madrigal-a/magsafe-console/hardware/compras.xlsx

Sheet: Resumen
MagSafe Console: lista de compra
Consolas a armar | 4 | Cambia este número y se recalcula la columna «Necesito».
Dónde | Total USD | Nota
Profe (a precio de LCSC) | $5.08 | Referencia para negociar
Profe (a precio de Mouser, pieza suelta) | $22.12 | Parcial: faltan piezas sin precio en Mouser
LCSC (lo que compro yo) | $30.78 | Sin envío ni impuestos
Total estimado (LCSC + profe a precio LCSC) | $35.86
No incluye: batería, pantalla, bocina, conector de la pantalla, placa y esténcil.

Sheet: Comprar al profe
Pieza | Descripción | Número de parte | LCSC | Por consola | Necesito | Pedir (con repuesto) | Precio LCSC (USD) | Subtotal LCSC | Precio Mouser 1 pza (USD) | Subtotal Mouser
Regulador 3.3 V | U2, alimenta todo a 3.3 V | AP2112K-3.3TRG1 | C51118 | 1 | 4 | 4 | 0.173 | $0.69 | 0.26 | $1.04 | x
Conector USB-C | J1, carga y datos | USB4085-GF-A | C165948 | 1 | 4 | 4 | 0.188 | $0.75 | 0.97 | $3.90 | x
MOSFET N | Q2, enciende la luz de la pantalla (reemplaza al AO3400A) | 2N7002 (SOT-23) | C8545 | 1 | 4 | 6 | 0.018 | $0.11 | 0.24 | $1.44 | x
Diodo Schottky | D3, reparto de carga (reemplaza al B5819W) | 1N5819HW-7-F | C82544 | 1 | 4 | 6 | 0.057 | $0.34 | 0.31 | $1.86 | x
Protección USB | Nueva, protege D+ y D- de estática | USBLC6-2P6 | C15999 | 1 | 4 | 6 | 0.249 | $1.49 | 0.69 | $4.14 | x
LED verde 0603 | D2, carga completa | KT-0805G o igual | C2297 | 1 | 4 | 8 | 0.017 | $0.14 |  | $0.14 | x
LED Azul 0603 | D1, cargando | el que tenga en 0603 |  | 1 | 4 | 8 | 0.020 | $0.16 | 0.25 | $2.00 | x
Resistencia 1 kΩ 0603 | R4, R5 |  | C21190 | 2 | 8 | 12 | 0.001 | $0.01 | 0.10 | $1.20 | x
Resistencia 3 kΩ 0603 | R3, corriente de carga |  | C4211 | 1 | 4 | 10 | 0.001 | $0.01 | 0.10 | $1.00 | x
Resistencia 5.1 kΩ 0603 | R1, R2 |  | C23186 | 2 | 8 | 12 | 0.001 | $0.01 | 0.10 | $1.20 | x
Resistencia 1 MΩ 0603 | R10, R11, R12 |  | C22935 | 3 | 12 | 16 | 0.001 | $0.02 | 0.10 | $1.60 | x
Capacitor 100 nF 0603 | C7, C8, C10, C11 |  | C14663 | 4 | 16 | 20 | 0.003 | $0.06 | 0.13 | $2.60 | x
Capacitor 1 µF 0603 | C3, C5 |  | C15849 | 2 | 8 | 12 | 0.006 | $0.07 |  |  | x
Capacitor 15 µF 0805, 10 V o más | C1, C2, C4, C6, C9, C12 |  | C19702 | 6 | 24 | 30 | 0.029 | $0.87 |  |  | x
Interruptor | SW1 (el profe lo tiene después) | MSK12C02 | C431540 | 1 | 4 | 6 | 0.057 | $0.34
TOTAL |  |  |  |  |  |  |  | $5.08 |  | $22.12
 |  |  |  |  |  |  |  |  |  | $25.65
Precios consultados el 13 de noviembre de 2026, sin envío ni impuestos.
Precio LCSC: el de la cantidad mínima de compra. Precio Mouser: por 1 pieza suelta; vacío = no encontré precio o Mouser no vende esa marca.
El subtotal de Mouser solo suma las piezas con precio, así que el total real sería mayor.
Azul = dato que puedes cambiar. «Pedir» incluye repuesto porque las piezas chicas se pierden al soldar.

Sheet: Comprar en LCSC
Pieza | Descripción | Número de parte | LCSC | Por consola | Necesito | Pedir (con repuesto) | Precio LCSC (USD) | Subtotal LCSC
ESP32 | U3, cerebro | ESP32-S3-WROOM-1-N16R8 | C2913202 | 1 | 4 | 4 | 4.950 | $19.80
Amplificador | U4, audio | MAX98357AETE+T | C910544 | 1 | 4 | 5 | 1.310 | $6.55
Cargador | U1, carga la batería | TP4056-42-ESOP8 | C16581 | 1 | 4 | 6 | 0.190 | $1.14
Ranura microSD | J4 | TF-01A | C91145 | 1 | 4 | 5 | 0.190 | $0.95
Botones frontales | SW2 a SW14 | TS-1187A-B-A-B | C318884 | 13 | 52 | 60 | 0.020 | $1.20
Gatillos | SW15, SW16 | TS24CA | C393942 | 2 | 8 | 10 | 0.030 | $0.30
MOSFET P | Q1, reparto de carga | AO3401A | C15127 | 1 | 4 | 6 | 0.090 | $0.54
Resistencia 10 Ω 0603 | R13 (se vende de 100 en 100) |  | C22859 | 1 | 4 | 100 | 0.001 | $0.10
Resistencia 10 kΩ 0603 | R7, R8, R9 (de 100 en 100) |  | C25804 | 3 | 12 | 100 | 0.001 | $0.10
Resistencia 100 kΩ 0603 | R6, R14, R15 (de 100 en 100) |  | C25803 | 3 | 12 | 100 | 0.001 | $0.10
TOTAL |  |  |  |  |  |  |  | $30.78
Precios aproximados de la lista del proyecto (hardware/piezas.md), sin envío ni impuestos; el carrito de LCSC da el precio final.
Algunas piezas tienen mínimo de compra; el carrito ajusta la cantidad.
Si el profe no tiene LED amarillo 0603, agrega el rojo KT-0603R (C2286). Si el interruptor tarda, agrega MSK12C02 (C431540).
