madrigal-a/magsafe-console/hardware/esquematico.pdf

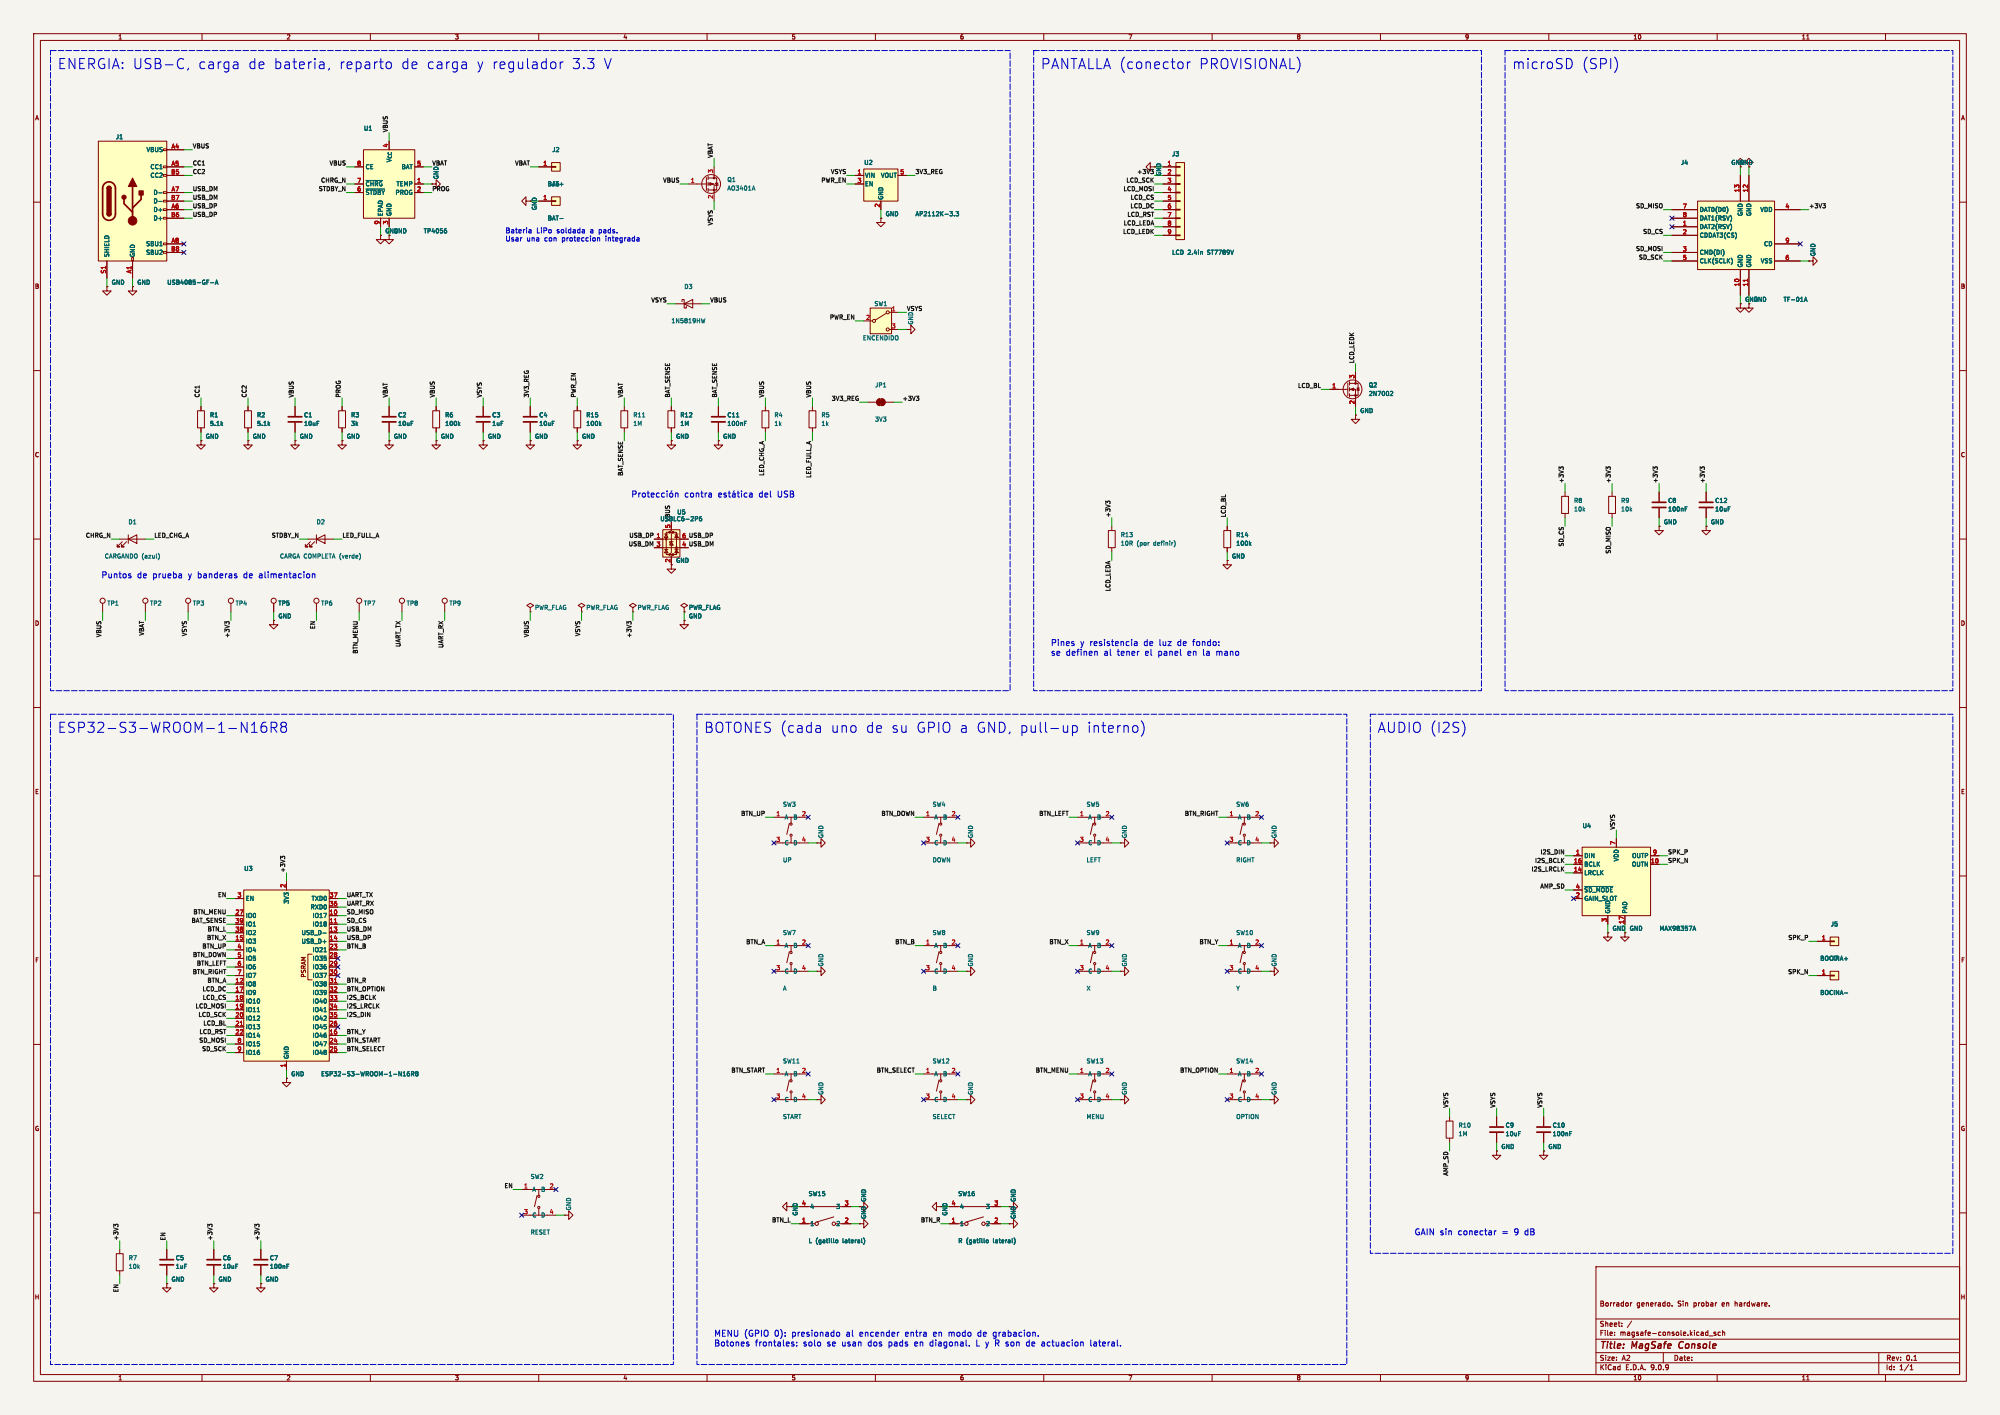
[picture p2: page 1]

3 BAT 5 TEMP 1 PROG 2 GND

þÿProtección contra þÿestática del USB

Puntos de prueba y banderas de alimentacion
