madrigal-a/magsafe-console/hardware/kicad/magsafe-console.kicad_pcb

## KiCad design hardware/kicad/magsafe-console.kicad_pcb (2026-11-13)

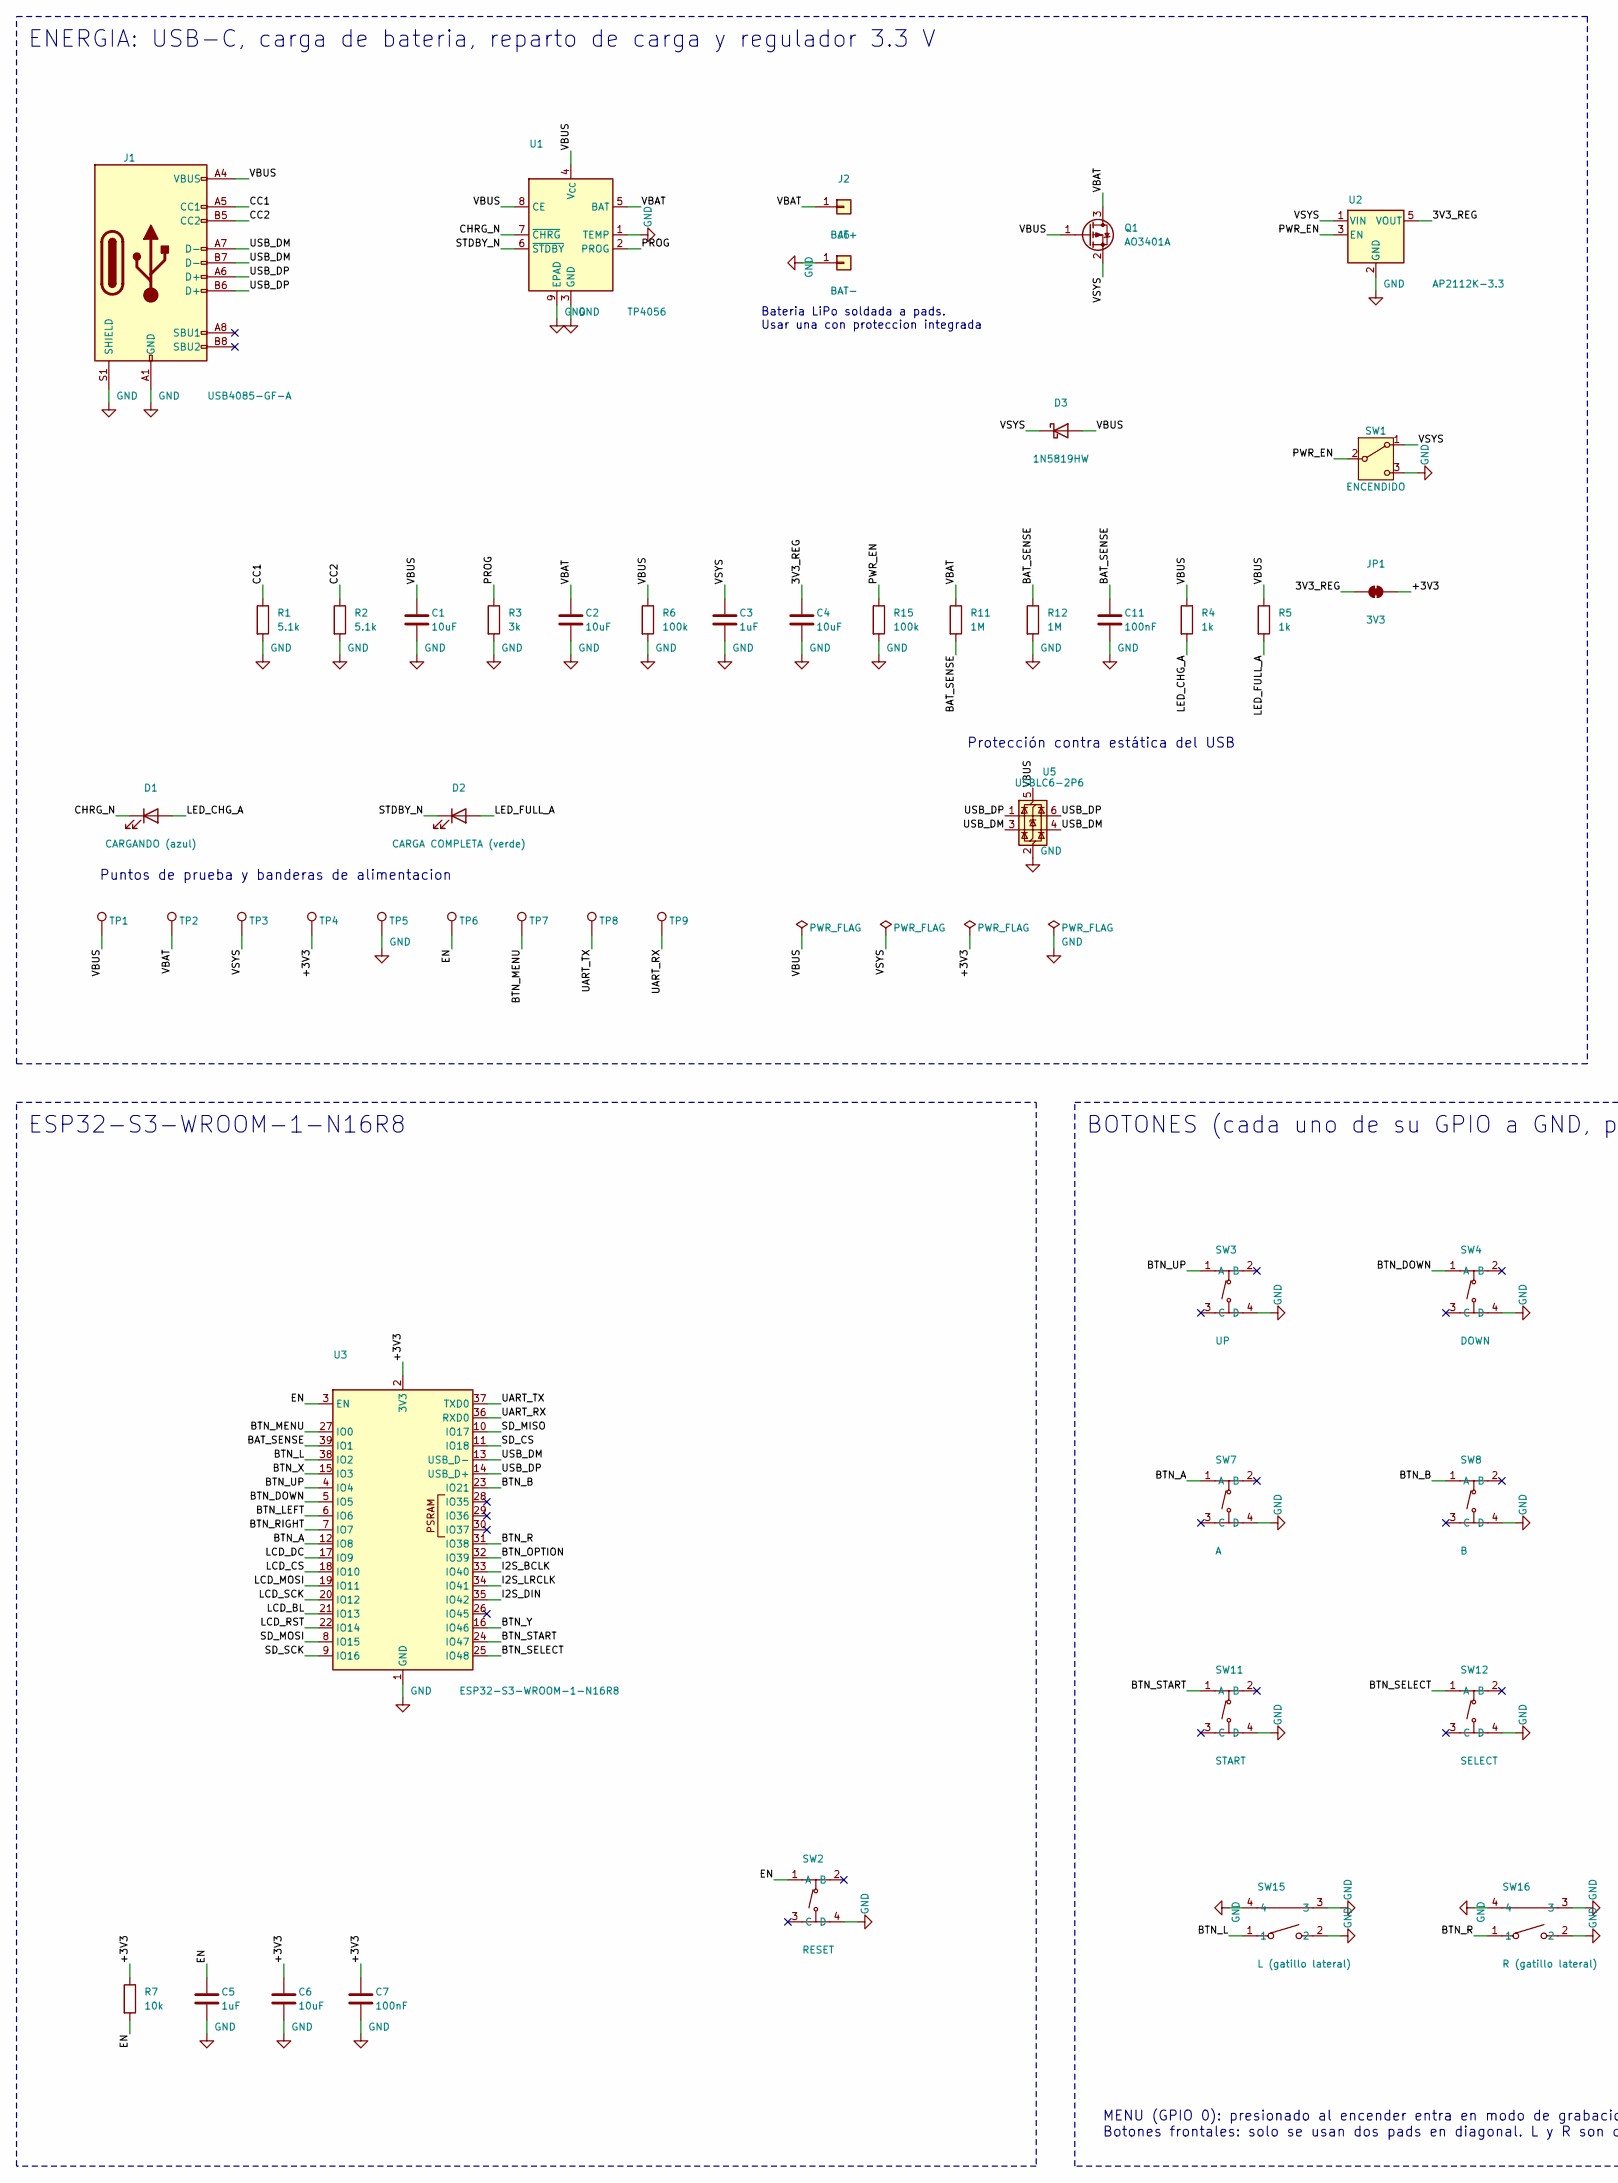
[picture p3: schematic magsafe-console.kicad_sch, MagSafe Console, part in row 1, column 1]

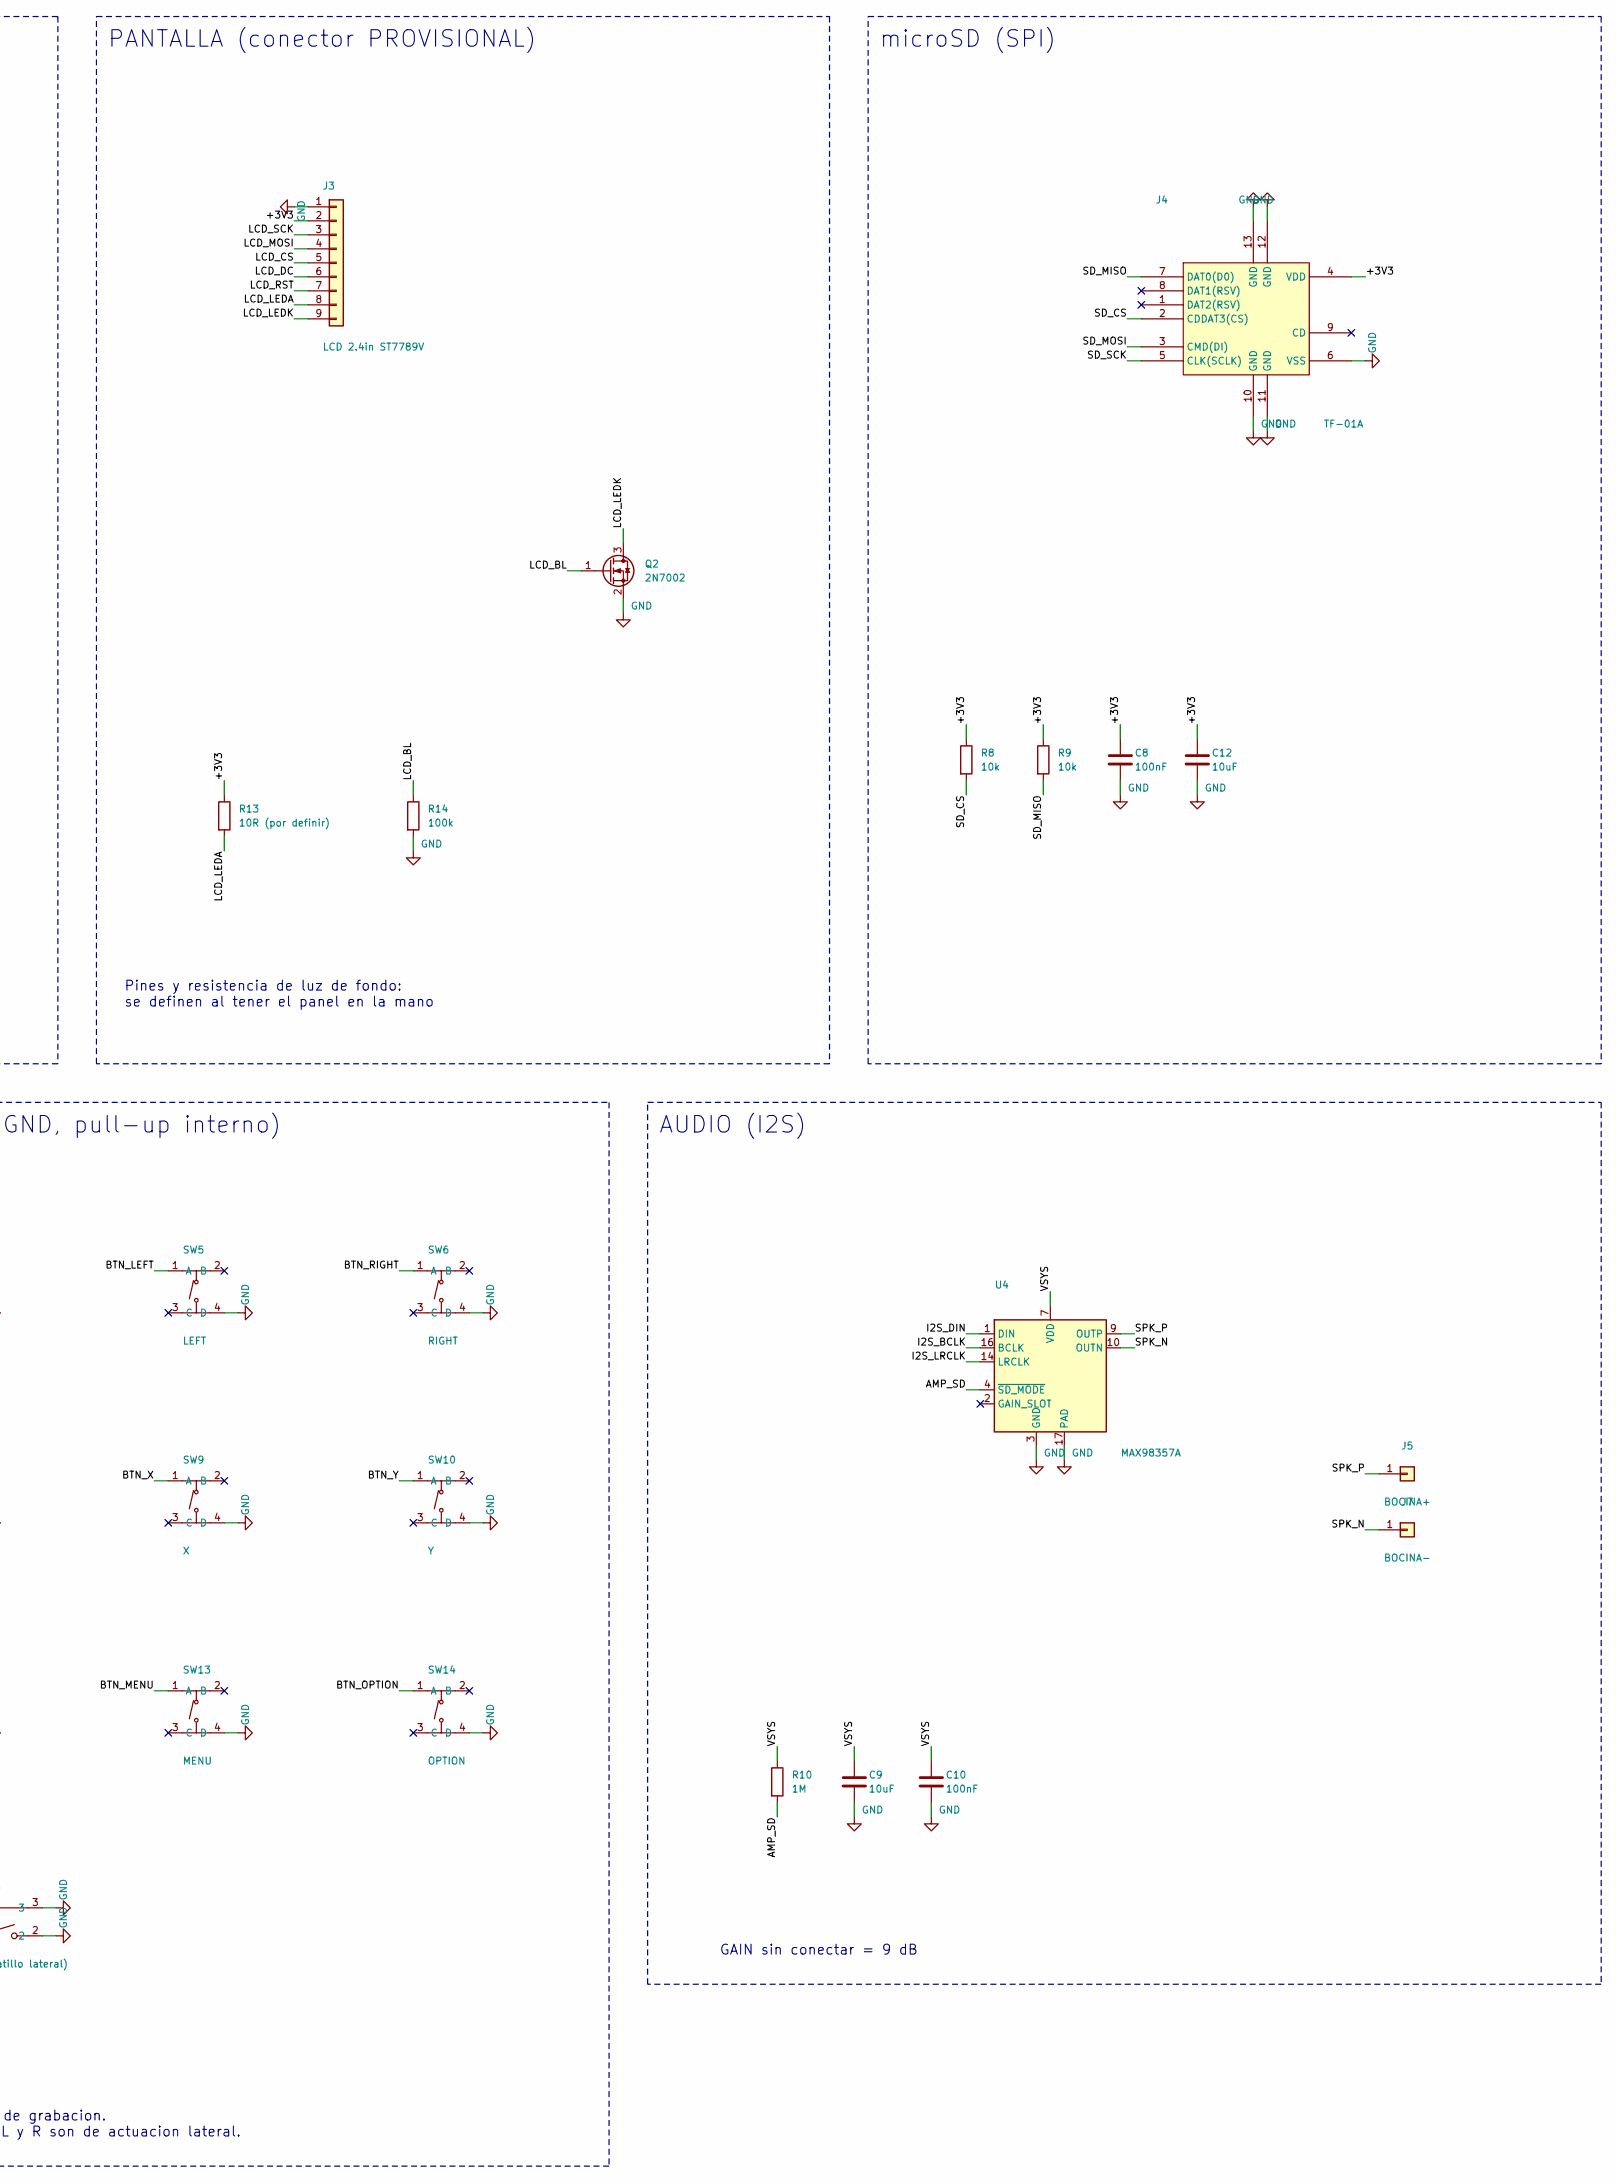
[picture p4: schematic magsafe-console.kicad_sch, MagSafe Console, part in row 1, column 2]

Parts:
C1, C2, C4, C6, C9, C12: 10uF; C_0805_2012Metric
C3, C5: 1uF; C_0603_1608Metric; LCSC C15849
C7, C8, C10, C11: 100nF; C_0603_1608Metric; LCSC C14663
D1: CARGANDO (azul); LED_0603_1608Metric
D2: CARGA COMPLETA (verde); LED_0603_1608Metric
D3: 1N5819HW; D_SOD-123; LCSC C82544
J1: USB4085-GF-A; USB_C_Receptacle_GCT_USB4085
J2: BAT+; SolderWirePad_1x01_SMD_1.5x3mm
J3: LCD 2.4in ST7789V
J4: TF-01A; TF-SMD_TF-01A; LCSC C91145
J5: BOCINA+; SolderWirePad_1x01_SMD_1x2mm
J6: BAT-; SolderWirePad_1x01_SMD_1.5x3mm
J7: BOCINA-; SolderWirePad_1x01_SMD_1x2mm
JP1: 3V3; SolderJumper-2_P1.3mm_Bridged_RoundedPad1.0x1.5mm
Q1: AO3401A; SOT-23; LCSC C15127
Q2: 2N7002; SOT-23; LCSC C8545
R1, R2: 5.1k; R_0603_1608Metric; LCSC C23186
R3: 3k; R_0603_1608Metric; LCSC C4211
R4, R5: 1k; R_0603_1608Metric; LCSC C21190
R6, R14, R15: 100k; R_0603_1608Metric; LCSC C25803
R7, R8, R9: 10k; R_0603_1608Metric; LCSC C25804
R10, R11, R12: 1M; R_0603_1608Metric; LCSC C22935
R13: 10R (por definir); R_0603_1608Metric; LCSC C22859
SW1: ENCENDIDO; SW_SPDT_Shouhan_MSK12C02; LCSC C431540
SW2: RESET; SW-SMD_4P-L5.1-W5.1-P3.70-LS6.5-TL_H1.5; LCSC C318884
SW3: UP; SW-SMD_4P-L5.1-W5.1-P3.70-LS6.5-TL_H1.5; LCSC C318884
SW4: DOWN; SW-SMD_4P-L5.1-W5.1-P3.70-LS6.5-TL_H1.5; LCSC C318884
SW5: LEFT; SW-SMD_4P-L5.1-W5.1-P3.70-LS6.5-TL_H1.5; LCSC C318884
SW6: RIGHT; SW-SMD_4P-L5.1-W5.1-P3.70-LS6.5-TL_H1.5; LCSC C318884
SW7: A; SW-SMD_4P-L5.1-W5.1-P3.70-LS6.5-TL_H1.5; LCSC C318884
SW8: B; SW-SMD_4P-L5.1-W5.1-P3.70-LS6.5-TL_H1.5; LCSC C318884
SW9: X; SW-SMD_4P-L5.1-W5.1-P3.70-LS6.5-TL_H1.5; LCSC C318884
SW10: Y; SW-SMD_4P-L5.1-W5.1-P3.70-LS6.5-TL_H1.5; LCSC C318884
SW11: START; SW-SMD_4P-L5.1-W5.1-P3.70-LS6.5-TL_H1.5; LCSC C318884
SW12: SELECT; SW-SMD_4P-L5.1-W5.1-P3.70-LS6.5-TL_H1.5; LCSC C318884
SW13: MENU; SW-SMD_4P-L5.1-W5.1-P3.70-LS6.5-TL_H1.5; LCSC C318884
SW14: OPTION; SW-SMD_4P-L5.1-W5.1-P3.70-LS6.5-TL_H1.5; LCSC C318884
SW15: L (gatillo lateral); SW-SMD_2P-TS24CA; LCSC C393942
SW16: R (gatillo lateral); SW-SMD_2P-TS24CA; LCSC C393942
TP1: VBUS; TestPoint_Pad_D1.0mm
TP2: VBAT; TestPoint_Pad_D1.0mm
TP3: VSYS; TestPoint_Pad_D1.0mm
TP4: +3V3; TestPoint_Pad_D1.0mm
TP5: GND; TestPoint_Pad_D1.0mm
TP6: EN; TestPoint_Pad_D1.0mm
TP7: BTN_MENU; TestPoint_Pad_D1.0mm
TP8: UART_TX; TestPoint_Pad_D1.0mm
TP9: UART_RX; TestPoint_Pad_D1.0mm
U1: TP4056; SOIC-8-1EP_3.9x4.9mm_P1.27mm_EP2.41x3.3mm_ThermalVias; LCSC C16581
U2: AP2112K-3.3; SOT-23-5; LCSC C51118
U3: ESP32-S3-WROOM-1-N16R8; ESP32-S3-WROOM-1_KeepoutReducido; LCSC C2913202
U4: MAX98357A; TQFN-16-1EP_3x3mm_P0.5mm_EP1.23x1.23mm; LCSC C910544
U5: USBLC6-2P6; SOT-666; LCSC C15999

Connections:
/3V3_REG: C4.1, JP1.1 (A), U2.5 (VOUT)
/+3V3: C6.1, C7.1, C8.1, C12.1, J3.2, J4.4 (VDD), JP1.2 (B), R7.1, R8.1, R9.1, R13.1, TP4.1, U3.2 (3V3)
/AMP_SD: R10.2, U4.4 (~SD_MODE)
/BAT_SENSE: C11.1, R11.2, R12.1, U3.39 (IO1)
/BTN_A: SW7.1 (A), U3.12 (IO8)
/BTN_B: SW8.1 (A), U3.23 (IO21)
/BTN_DOWN: SW4.1 (A), U3.5 (IO5)
/BTN_L: SW15.1, U3.38 (IO2)
/BTN_LEFT: SW5.1 (A), U3.6 (IO6)
/BTN_MENU: SW13.1 (A), TP7.1, U3.27 (IO0)
/BTN_OPTION: SW14.1 (A), U3.32 (IO39)
/BTN_R: SW16.1, U3.31 (IO38)
/BTN_RIGHT: SW6.1 (A), U3.7 (IO7)
/BTN_SELECT: SW12.1 (A), U3.25 (IO48)
/BTN_START: SW11.1 (A), U3.24 (IO47)
/BTN_UP: SW3.1 (A), U3.4 (IO4)
/BTN_X: SW9.1 (A), U3.15 (IO3)
/BTN_Y: SW10.1 (A), U3.16 (IO46)
/CC1: J1.A5 (CC1), R1.1
/CC2: J1.B5 (CC2), R2.1
/CHRG_N: D1.1 (K), U1.7 (~CHRG)
/EN: C5.1, R7.2, SW2.1 (A), TP6.1, U3.3 (EN)
/I2S_BCLK: U3.33 (IO40), U4.16 (BCLK)
/I2S_DIN: U3.35 (IO42), U4.1 (DIN)
/I2S_LRCLK: U3.34 (IO41), U4.14 (LRCLK)
/LCD_BL: Q2.1 (G), R14.1, U3.21 (IO13)
/LCD_CS: J3.5, U3.18 (IO10)
/LCD_DC: J3.6, U3.17 (IO9)
/LCD_LEDA: J3.8, R13.2
/LCD_LEDK: J3.9, Q2.3 (D)
/LCD_MOSI: J3.4, U3.19 (IO11)
/LCD_RST: J3.7, U3.22 (IO14)
/LCD_SCK: J3.3, U3.20 (IO12)
/LED_CHG_A: D1.2 (A), R4.2
/LED_FULL_A: D2.2 (A), R5.2
/PROG: R3.1, U1.2 (PROG)
/PWR_EN: R15.1, SW1.2 (B), U2.3 (EN)
/SD_CS: J4.2 (CDDAT3(CS)), R8.2, U3.11 (IO18)
/SD_MISO: J4.7 (DAT0(D0)), R9.2, U3.10 (IO17)
/SD_MOSI: J4.3 (CMD(DI)), U3.8 (IO15)
/SD_SCK: J4.5 (CLK(SCLK)), U3.9 (IO16)
/SPK_N: J7.1, U4.10 (OUTN)
/SPK_P: J5.1, U4.9 (OUTP)
/STDBY_N: D2.1 (K), U1.6 (~STDBY)
/UART_RX: TP9.1, U3.36 (RXD0)
/UART_TX: TP8.1, U3.37 (TXD0)
/USB_DM: J1.A7 (D-), J1.B7 (D-), U3.13 (USB_D-), U5.3 (I/O2), U5.4 (I/O2)
/USB_DP: J1.A6 (D+), J1.B6 (D+), U3.14 (USB_D+), U5.1 (I/O1), U5.6 (I/O1)
/VBAT: C2.1, J2.1, Q1.3 (D), R11.1, TP2.1, U1.5 (BAT)
/VBUS: C1.1, D3.2 (A), J1.A4 (VBUS), J1.A9 (VBUS), J1.B4 (VBUS), J1.B9 (VBUS), Q1.1 (G), R4.1, R5.1, R6.1, TP1.1, U1.4 (V_{CC}), U1.8 (CE), U5.5 (VBUS)
/VSYS: C3.1, C9.1, C10.1, D3.1 (K), Q1.2 (S), R10.1, SW1.1 (A), TP3.1, U2.1 (VIN), U4.7 (VDD), U4.8 (VDD)
GND: C1.2, C2.2, C3.2, C4.2, C5.2, C6.2, C7.2, C8.2, C9.2, C10.2, C11.2, C12.2, J1.A1 (GND), J1.A12 (GND), J1.B1 (GND), J1.B12 (GND), J1.S1 (SHIELD), J3.1, J4.6 (VSS), J4.10 (GND), J4.11 (GND), J4.12 (GND), J4.13 (GND), J6.1, Q2.2 (S), R1.2, R2.2, R3.2, R6.2, R12.2, R14.2, R15.2, SW1.3 (C), SW2.4 (D), SW3.4 (D), SW4.4 (D), SW5.4 (D), SW6.4 (D), SW7.4 (D), SW8.4 (D), SW9.4 (D), SW10.4 (D), SW11.4 (D), SW12.4 (D), SW13.4 (D), SW14.4 (D), SW15.2, SW15.3, SW15.4, SW16.2, SW16.3, SW16.4, TP5.1, U1.1 (TEMP), U1.3 (GND), U1.9 (EPAD), U2.2 (GND), U3.1 (GND), U3.40 (GND), U3.41 (GND), U4.3 (GND), U4.11 (GND), U4.15 (GND), U4.17 (PAD), U5.2 (GND)

Notes on the sheet:
ENERGIA: USB-C, carga de bateria, reparto de carga y regulador 3.3 V
Bateria LiPo soldada a pads. Usar una con proteccion integrada
Puntos de prueba y banderas de alimentacion
ESP32-S3-WROOM-1-N16R8
BOTONES (cada uno de su GPIO a GND, pull-up interno)
MENU (GPIO 0): presionado al encender entra en modo de grabacion. Botones frontales: solo se usan dos pads en diagonal. L y R son de actuacion lateral.
PANTALLA (conector PROVISIONAL)
Pines y resistencia de luz de fondo: se definen al tener el panel en la mano
microSD (SPI)
AUDIO (I2S)
GAIN sin conectar = 9 dB
Protección contra estática del USB

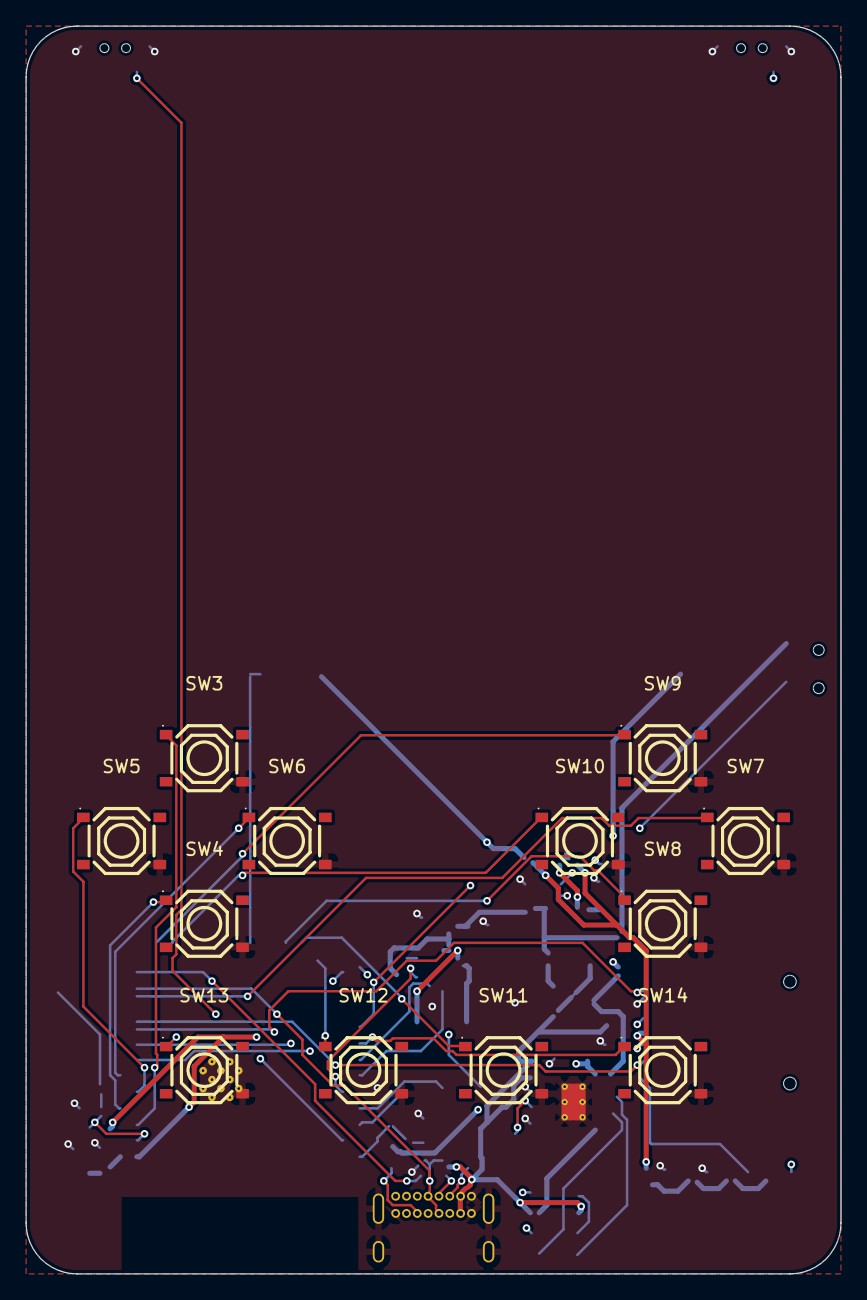
[picture p5: board magsafe-console.kicad_pcb from above]

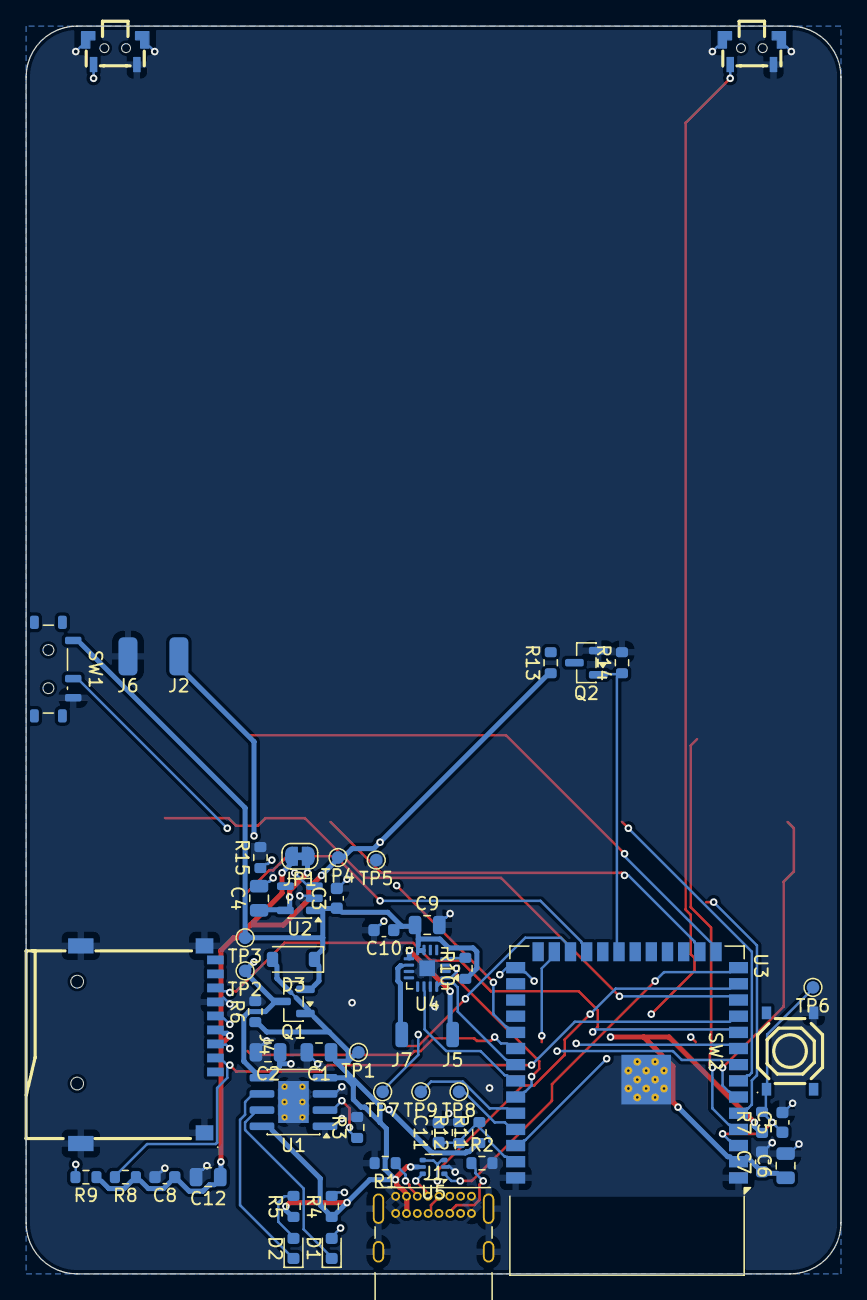
[picture p6: board magsafe-console.kicad_pcb from below]

Board: 4 copper layers, 64.0 x 98.0 mm, 69 parts (57 on the bottom side), 45 nets.
