madrigal-a/magsafe-console/(commit log)

2026-11-10 Estructura inicial: guia del prototipo, target de Retro-Go y plan de hardware
    Claude-Session: https://claude.ai/code/session_01TyTZgGGMfv1kppEZQi1aux
2026-11-11 Agrega el diseño del circuito por bloques
    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
2026-11-11 Agrega el esquematico v0.1 en KiCad
    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
    [magsafe-console.kicad_sch]
2026-11-11 Verifica piezas en JLCPCB, asigna huellas y agrega libreria del proyecto
    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
    [magsafe-console.kicad_sch]
2026-11-11 Agrega firmware compilado y plano de acomodo
    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
2026-11-11 Agrega botones X, Y y gatillos L y R laterales
    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
    [magsafe-console.kicad_sch]
2026-11-11 Revisa huellas contra hojas de datos e inicia la PCB
    - Corrige la huella de la microSD TF-01A: contactos 0.1 mm corridos
    - Agujeros de postes como no metalizados en TS24CA y TF-01A
    - Huella del ESP32 con zona prohibida solo bajo la antena
    - Saca puntos de prueba, pads de cable y puente del listado de materiales
    - PCB: contorno 64x98, 68 huellas con redes, colocacion inicial, sin pistas
    - Menu y Option en fila con Select y Start; interruptor mas arriba
    Claude-Session: https://claude.ai/code/session_01TyTZgE6akHExZXWd6cMpFc
    [magsafe-console.kicad_pcb, magsafe-console.kicad_sch]
2026-11-11 Pasa resistencias y condensadores a 0603 y documenta el armado a mano
    - Esquematico: huellas 0603 y numeros LCSC de las piezas 0603
    - PCB: recolocacion de las piezas chicas, sin piezas encimadas
    - Documentos: la placa completa se arma a mano; se descarta el ensamble en JLCPCB
    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
    [magsafe-console.kicad_pcb, magsafe-console.kicad_sch]
2026-11-11 Agrega la lista de pendientes y anota la compra de piezas en LCSC
    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
2026-11-11 Pasa la placa a 4 capas y traza todo menos la pantalla
    Agrega plano de tierra interno, 482 tramos y 102 vías con un trazador
    automático propio, la lista de compra de LCSC y la batería elegida.
    Claude-Session: https://claude.ai/code/session_01TyTZgCjnpUNc5hoFysKEJw
    [lista-lcsc.csv, magsafe-console.kicad_pcb]
2026-11-11 Baja la corriente de carga: R3 pasa a 3 kΩ (unos 400 mA)
    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
    [lista-lcsc.csv, magsafe-console.kicad_pcb, magsafe-console.kicad_sch]
2026-11-13 Adapta la placa a las piezas del profesor
    USB-C GCT USB4085 de pines atravesados, protección USBLC6-2P6,
    capacitores de filtrado en 0805, LED en 0603, 2N7002 y 1N5819HW.
    Trazado rehecho: cero errores de reglas.
    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
    [compras.xlsx, lista-lcsc.csv, magsafe-console.kicad_pcb, magsafe-console.kicad_sch]
